horned128/sound_exprore_tmp/hardware/actuator/docs/jga25-370-12v-300rpm.md

# JGA25-370 エンコーダ付きDCギヤードモーター仕様書（12 V・300 RPM）

## 購入仕様

| 項目 | 内容 |
|---|---|
| 製品 | JGA25-370 エンコーダ付きDCギヤードモーター |
| 購入した電圧 | DC 12 V |
| 購入した速度 | 300 RPM |
| 販売ページ | [AliExpress 商品番号 1005008515616137](https://ja.aliexpress.com/item/1005008515616137.html) |
| 修正日 | 2026-08-17 |

以前の文書では100 RPM品として整理していましたが、実際の購入品は300 RPM品だったため訂正しました。旧文書に記載していた減速比46:1、定格負荷時100 RPM、506パルス/回転/相、2024カウント/回転は100 RPM品を仮定した値であり、本機には適用しません。

「300 RPM」が無負荷速度と定格負荷速度のどちらを表すかは販売ページだけでは確定できません。本書では購入バリエーションの公称値として扱い、制御に使う実回転数はエンコーダで測定します。

## 1. 確認済み仕様

| 項目 | 仕様 | 確度 |
|---|---:|---|
| 製品シリーズ | JGA25-370 / 25GA370 | 購入情報 |
| モーター形式 | ブラシ付きDCモーター、減速ギヤボックス付き | 購入情報 |
| 定格電圧 | DC 12 V | 購入情報 |
| 購入速度 | 300 RPM | 購入品確認 |
| 回転方向 | モーター電源の極性反転により正逆転 | シリーズ共通 |
| エンコーダ | A相・B相の2相出力 | 購入情報 |
| 出力軸直径 | 4 mm | 購入資料 |
| 出力軸形状 | Dカット軸 | 購入資料 |
| 出力軸長さ | 約9.5 mm | 購入資料。実物を再測定すること |

公称300 RPMは1秒あたり5回転、角速度では約31.42 rad/sです。

```text
300 RPM / 60 = 5 回転/秒
300 RPM × 2π / 60 ≒ 31.42 rad/s
```

## 2. 機械寸法

単位：mm

| 寸法項目 | 寸法 |
|---|---:|
| モーター直径 | 約24.5 |
| ギヤボックス直径 | 約25 |
| ギヤボックス長 | 約21 |
| 出力軸直径 | 4 |
| 出力軸形状 | Dカット |
| 出力軸長さ | 約9.5 |
| 前面取付穴 | 2×M3×0.5、中心間17（25GA370系列図面値） |
| ねじのギヤボックス内侵入長 | 最大3.0を暫定上限とする（実機優先） |

### M3取付ねじを深く入れない

25GA370系列の寸法図では、前面のM3取付ねじについて「Screw length max 3.0」と指定されています。これはブラケットを含むねじ全長ではなく、ギヤボックス前面から内部へ入るねじ部の長さとして扱います。

```text
使用するM3ねじの長さ <= ブラケット厚さ + 3.0 mm
```

ねじが深すぎると、先端が内部の平歯車、歯車軸、軸受板へ接触して回転を物理的に止める可能性があります。強く締めすぎた場合は、薄いギヤボックス前板を変形させて歯車軸を傾け、歯面を強く噛み合わせることもあります。どちらの場合もモーターはストール状態となり、大電流と発熱が発生します。

取付時はブラケット厚さをノギスで測り、必要ならM3平ワッシャーまたはスペーサーで侵入長を3.0 mm以下にします。電源を入れる前に出力軸を手で回し、ねじを締めた後だけ急に重くなる場合は直ちに短いねじへ交換します。購入品のロット固有図面または実測で、より小さい許容値が判明した場合はそちらを優先します。

販売店やロットによって軸長の記載には差があります。ホイールハブを購入する前に、6台すべてについて次をノギスで確認してください。

- 軸径が4 mmであること
- 軸先端からギヤボックス端面までの有効長
- Dカット平面の長さと向き
- ハブを挿入したとき、止めねじがDカット面へ当たる位置
- ハブ、モーターマウント、ホイール間の干渉余裕

`rim_hexagonal.stl`へ変更する場合のハブ選定と固定方法は、[JGA25-370用12 mm真鍮六角ハブ選定](jga25-wheel-hub-adapter.md)を参照してください。

## 3. 300 RPM品で未確定の性能値

旧100 RPM文書の次の値は減速比46:1の行を仮定していたため、300 RPM品の仕様として使用しません。

- 減速比
- 無負荷速度と定格負荷速度の対応
- 無負荷電流、定格負荷電流、ストール電流
- 定格負荷トルク、ストールトルク
- 出力軸1回転あたりのエンコーダカウント

JGA25-370には複数のギヤ比と速度バリエーションがあり、「JGA25-370・300 RPM」という名称だけでは上記を一意に決められません。販売者の300 RPM行または実測値を取得できた時点で追記します。

## 4. エンコーダ仕様と校正

| 項目 | 仕様 |
|---|---|
| エンコーダ電源 | DC 3.3～5 V |
| 出力信号 | A相・B相 |
| 信号線 | 黄：A相、緑：B相 |
| モーター軸分解能 | 11信号/回転とする販売情報あり。定義は要確認 |
| 出力軸分解能 | 未確定。実測して設定する |

減速比を `G`、モーター軸の各相パルス数を11 PPRと仮定した場合の理論式は次のとおりです。

```text
各相パルス数/出力軸1回転 = 11 × G
4逓倍カウント/出力軸1回転 = 11 × G × 4 = 44 × G
```

ただし、「11信号」が各相の立上り数か、A/B合計か、両エッジを含むかは販売表記だけでは確定しません。次の手順で実測値を決めます。

1. 車体を浮かせ、代表モーターのA相・B相をマイコンへ接続する。
2. 低PWMでゆっくり回すか、電源を切った状態で出力軸へ目印を付けて手で回す。
3. 出力軸を正確に10回転させ、4逓倍の累積カウントを記録する。
4. 累積カウントを10で割り、1回転あたりのカウントを求める。
5. 正転と逆転、左代表と右代表で同じ測定を行う。
6. 得られた値をCPU1の `JGA25_ENCODER_COUNTS_PER_REV` へ設定する。

測定値が確定するまで、旧100 RPM品由来の2024 count/revを使用してRPMを算出しないでください。

## 5. 配線仕様

| 線色 | 機能 | 接続先 |
|---|---|---|
| 赤 | モーター電源 | BTS7960のM+またはM- |
| 白 | モーター電源 | BTS7960の反対側のモーター端子 |
| 黄 | エンコーダA相 | EK-RA8P1の割込み入力 |
| 緑 | エンコーダB相 | EK-RA8P1の割込み入力 |
| 青 | エンコーダ電源 | DC 3.3 Vを優先して使用 |
| 黒 | エンコーダGND | EK-RA8P1、BTS7960と共通GND |

エンコーダ電源へ12 Vを印加してはいけません。出力回路形式とHigh電圧は販売情報から確定できないため、3.3 Vで給電し、オシロスコープまたはロジックアナライザで確認してからEK-RA8P1へ接続します。

## 6. 制御上の注意

- 300 RPMはオープンループPWMの上限換算値であり、指令値と実回転数が一致する保証はありません。
- 正確なRPM制御には、実測したcount/revとエンコーダフィードバックが必要です。
- 低速では静止摩擦のため回り始めない領域があります。
- 急な始動、停止、正逆転はギヤ、六角ハブ、ホイール、BTS7960へ衝撃を与えます。
- ソフトスタートを使用し、正逆転の切替前にPWMを0へ戻します。
- 300 RPMでは100 RPM品よりホイールの振動とアンバランスの影響が大きいため、ハブの偏心とねじの緩みを確認します。
- ストール状態で連続通電しません。

## 7. ソフトウェア設定との対応

CPU1の設定では、モーター指令のオープンループ換算上限を300 RPMにしています。

```c
#define JGA25_TARGET_RPM_MAX (300)
```

この値はPWMデューティ換算用の指令スケールです。エンコーダ校正前は閉ループ速度制御ではありません。円走行サンプルの左120 RPM、右150 RPMという値も、エンコーダ無効時は公称300 RPMに対するオープンループ指令値として扱います。

## 8. 初回確認項目

1. 無負荷で低PWMから始動する。
2. 左右の正転方向を確認する。
3. 無負荷で60秒運転し、異音、偏心、ハブの緩みを確認する。
4. A/B相の電圧と位相差を測定する。
5. 出力軸1回転あたりの実カウントを測定する。
6. 無負荷回転数と電流を測定する。
7. 車体を接地し、PWMを段階的に増やして走行電流と温度を記録する。
8. 初回走行後に六角ハブの止めねじと中央ねじを増し締めする。

## 9. 設計用要約

```text
製品              : JGA25-370 エンコーダ付きDCギヤードモーター
定格電圧          : DC 12 V
購入速度          : 300 RPM
出力軸            : 直径4 mm、Dカット、長さ約9.5 mm（実測要）
ギヤボックス直径  : 約25 mm
エンコーダ電源    : DC 3.3～5 V
エンコーダ信号    : A相・B相
減速比            : 未確定
出力軸count/rev    : 未確定、実測後に設定
推奨ホイール接続  : 4 mm穴・対辺12 mm・真鍮製六角ハブ
```

## 10. 出典と位置付け

- [AliExpress 商品番号 1005008515616137](https://ja.aliexpress.com/item/1005008515616137.html)
- [25GA370/280系列寸法図（2-M3×0.5、Screw length max 3.0 mm）](https://p.globalsources.com/IMAGES/PDT/SPEC/101/K1139071101.pdf)
- ユーザーによる購入速度の確認（300 RPM）
- 旧文書へ転記されていた購入資料の機械寸法

本書は購入情報と実機確認を整理した設計資料であり、メーカー発行の一意な正式データシートではありません。販売情報と実測値が異なる場合は、測定条件を記録した実測値を設計基準として採用します。
