horned128/sound_exprore_tmp/(list of files, cad)

Other CAD files:
hardware/papaya-addon/step/crown_mic_array.step
hardware/papaya-addon/step/tower_mic_array_.step
hardware/papaya-addon/step/body_ekra8p1.step
hardware/papaya-addon/step/bridge_ekra8p.step
hardware/papaya-addon/stl/body_ekra8p1.stl
hardware/papaya-addon/stl/bridge_ekra8p.stl
hardware/papaya-addon/stl/crown_mic_array.stl
hardware/papaya-addon/stl/tower_mic_array_.stl
