horned128/sound_exprore_tmp/(commit log)

2026-07-31 init: EK-RA8P1マルチコア向け初期プロジェクト(firmware/ra8p1)
    [body_ekra8p1.step, body_ekra8p1.stl, bridge_ekra8p.step, bridge_ekra8p.stl, crown_mic_array.step, crown_mic_array.stl, tower_mic_array_.step, tower_mic_array_.stl]
2026-07-31 feat: mtk3_bsp2をサブモジュールとしてfirmware/ra8p1に追加し、μTKernelをCPU0(CM85)で動作確認
2026-07-31 fix: 前回のコミットで追加し忘れた変更
2026-07-31 feat: hardware/papaya-pathfinderをサブプロジェクトとして追加(.gitattributesには追加済み)
